JoeyStrandnes/EVB_500-Throttle/Project images/Electrical-Connections.png

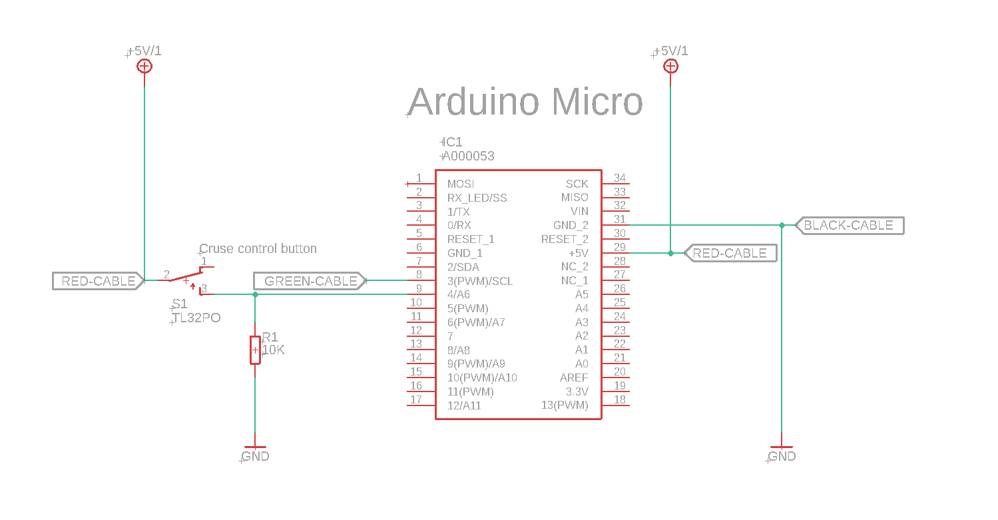
Project images/Electrical-Connections.png
