JoeyStrandnes/EVB_500-Throttle/Project images/Max throttle.BMP

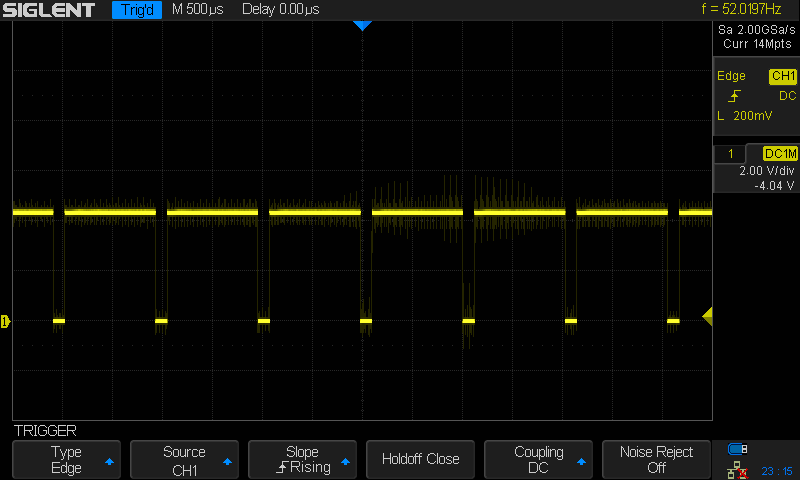
Project images/Max throttle.BMP
