JoeyStrandnes/EVB_500-Throttle/Project images/No throttle.BMP

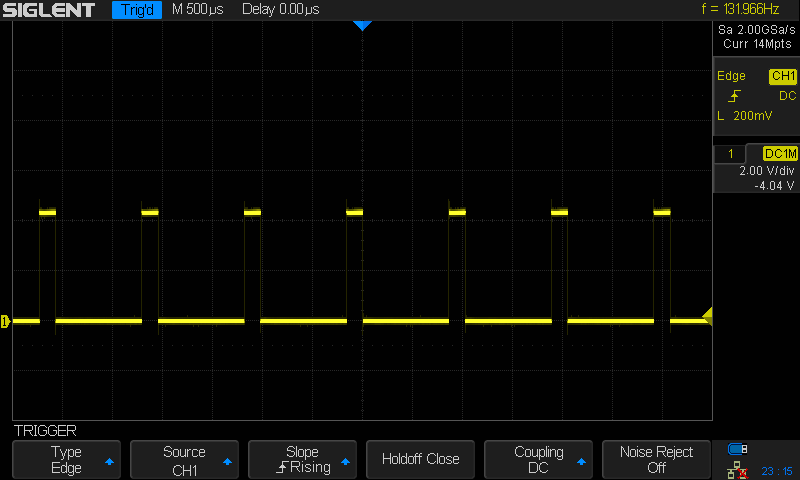
Project images/No throttle.BMP
