JoeyStrandnes/EVB_500-Throttle/Project images/Electrical Connections.sch

## EAGLE design Project images/Electrical Connections.sch (2020-07-03)

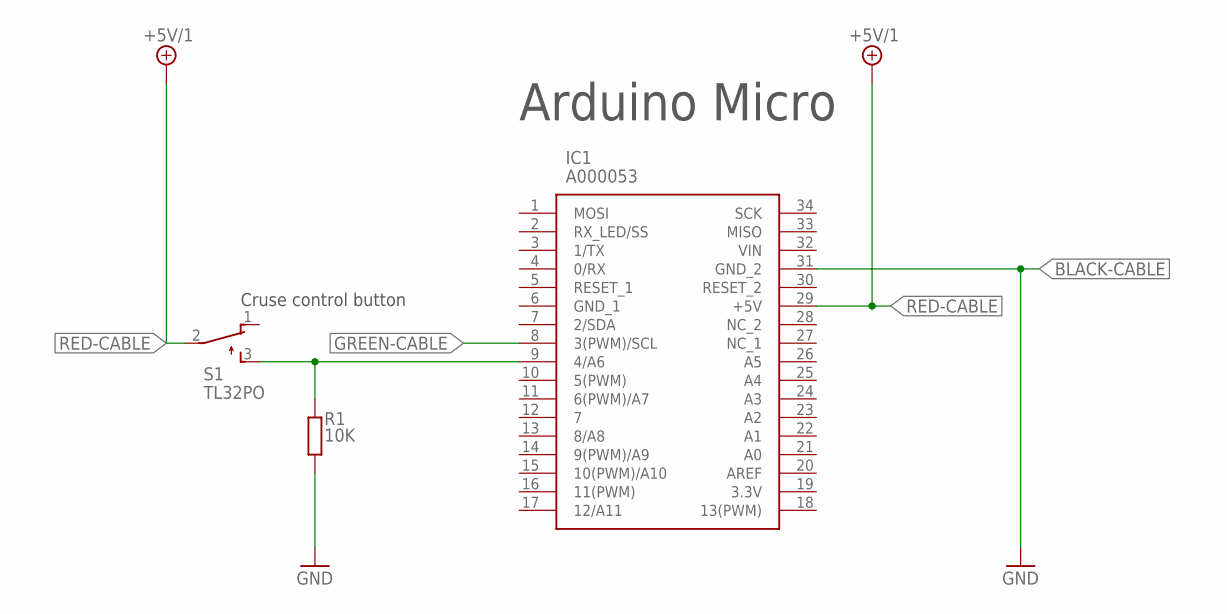
[picture p4: schematic Electrical Connections.sch]

Parts:
IC1: A000053; HDRV34W70P1570X254_2X17_4900X1
R1: 10K; R0603
S1: TL32PO; TL3XPO

Connections:
BLACK-CABLE: IC1.31 (GND_2)
GND: R1.2
GREEN-CABLE: IC1.8 (3(PWM)/SCL)
unnamed: IC1.9 (4/A6), R1.1, S1.3 (S)
RED-CABLE: IC1.29 (+5V), S1.2

Notes on the sheet:
Cruse control button
Arduino Micro
