JoeyStrandnes/EVB_500-Throttle/(threads)

Thread 1 (2023-02-09):

D49E Manufacturer

Be4stElectrjc, 2023-02-09:
Are you sure that the manufacturer is YZPST? In the datasheet the marking doesn't match.

All the best

JoeyStrandnes, 2023-02-09:
Hi,

I'm not completely certain that they are the manufacturer but they were the only one that I could find that produced a linear hall-effect sensor in that package, pinout and markings.
- The package is the same.
- Pinout is the same (legs were ripped off but the cable connections were connected to the correct pinout).
- Marking was almost the same, only differing very slightly.

Have you found a better suiting sensor?

Regards
Joseph

The below image is of the sensor and datasheet.
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

Be4stElectrjc, 2023-02-10:
There are a lot of manufacturers for the 49E and products are similar although not identical. Asked high-resolution photos of their [product](https://www.globalsources.com/Magnetic-sensor/Hall-Effect-Linear-Position-Sensor-1139513440p.htm), but even the marking indicated on the datasheet shows three characters (49E) like all other vendors do.

JoeyStrandnes, 2023-02-12:
Interesting, I believe that the one I found was the only one available Chinese electronic retailers. This was also three years ago so they don't seem be sell them anymore.

I wouldn't be too worried about the manufacturer though, it seems to be a jellybean component with quite simple specifications.
An alternative would be to replace the throttle with a generic electric scooter thumb throttle and slightly modify my code for the variable speed. Make sure to convert the 0-5V signal from the scooter throttle to a 0.9-4.2V signal for the EVB-500, this can be done with my mod.
Might add that using a button isn't as bad as it might seem, its a very simple fix but works pretty well.

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

Be4stElectrjc, 2023-02-13:
It was just to find the right manufacturer, curiosity.

Closed 2023-02-23.
